OZ1LQO/Arduino-SWR-PWR-Instrument/README.md

# Arduino-SWR-PWR-Instrument
Arduino Based QRP SWR and PWR instrument

English Below!

Dette er diagram, kode og et oversigtsbillede af mit Arduino baserede QRP SWR/PWR meter som
jeg holder foredrag om på EDR's sommerlejr 2015. Det er ikke ment som en komplet bygge instruktion,
det er det, der bliver gennemgået på foredraget. Du er velkommen til at kontakte mig, hvis du gerne vil 
i gang med projektet, altså hvis der er flere spm. efter foredraget :-) Jeg kommer også gerne rundt i
lokalafdelinger og fortæller om projektet, hvis der er interesse for det. Best 73 - OZ1LQO

English:
This is the Arduino source code, schematics and some pictures of my Arduino based QRP SWR/PWR meter,
which I'll be doing a talk on, at the yearly Danish Radio Amateur summer camp. It's not meant as a complete
project description, merely a container with the SW, for the people who would want to copy the project
after my talk. Are you interested in duplicating my project? Feel free to contact me, and I'll direct you to
the technical sources and help you getting started! Best 73 - OZ1LQO
