OZ1LQO/Arduino-SWR-PWR-Instrument/SWR_PWR_meter_overview-3.pdf

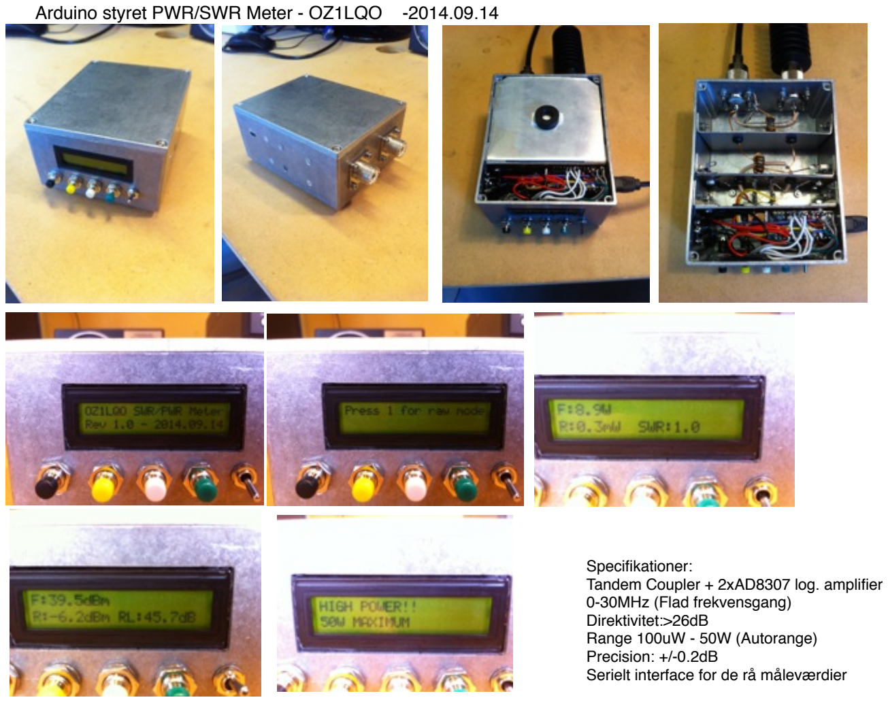
[picture p1: page 1]

Arduino styret PWR/SWR Meter - OZ1LQO -2014.09.14

Specifikationer:
Tandem Coupler + 2xAD8307 log. amplifier 0-30MHz (Flad frekvensgang) Direktivitet:>26dB
Range 100uW - 50W (Autorange) Precision: +/-0.2dB
Serielt interface for de rå måleværdier
