OZ1LQO/Arduino-SWR-PWR-Instrument/Arduino_swr_pwr_raw_diag.pdf

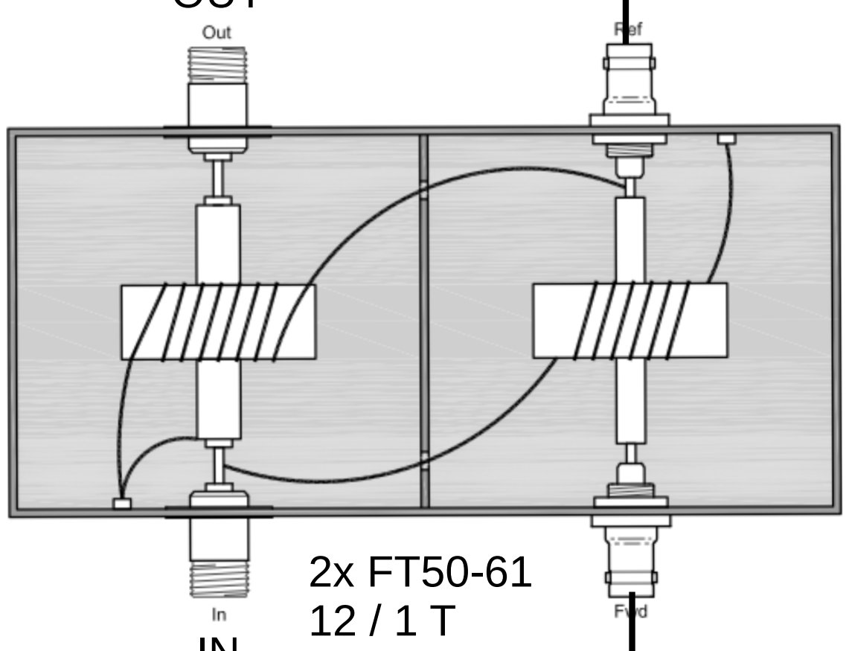
[picture p2: figure]

# FWD

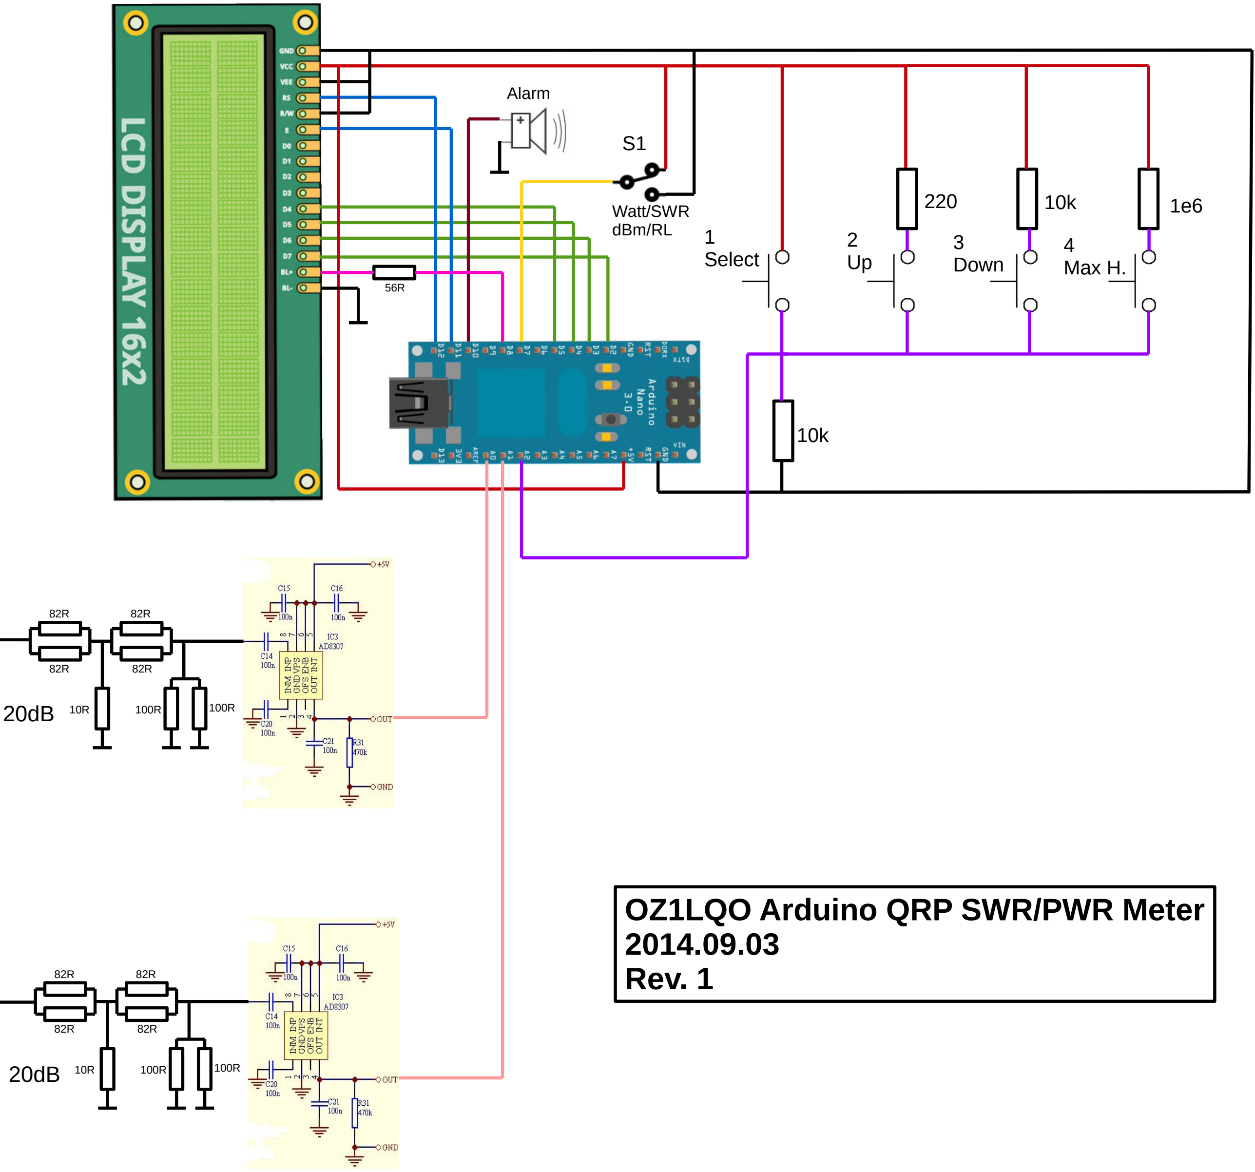
[picture p3: figure]
1 Select; 4 Max H.; OZ1LQO Arduino QRP SWR/PWR Meter 2014.09.03 Rev. 1; Watt/SWR dBm/RL; Alarm; 3 Down

REF | 82R

# OUT

IN
